MichaelDarr/liclock/README.md

# liclock
the libre chess clock

This document is a work in progress!
