MichaelDarr/liclock/enclosure/liclock.stl

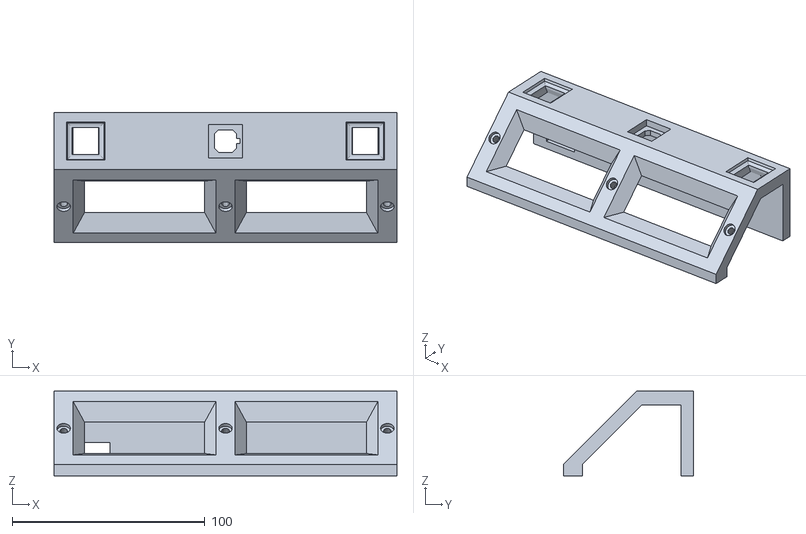
[picture p1: CAD file, 2024-03-15]
enclosure/liclock.stl
178.0 x 67.6 x 44.0
