MichaelDarr/liclock/enclosure/mcs_18_front/mcs_18_front.stl

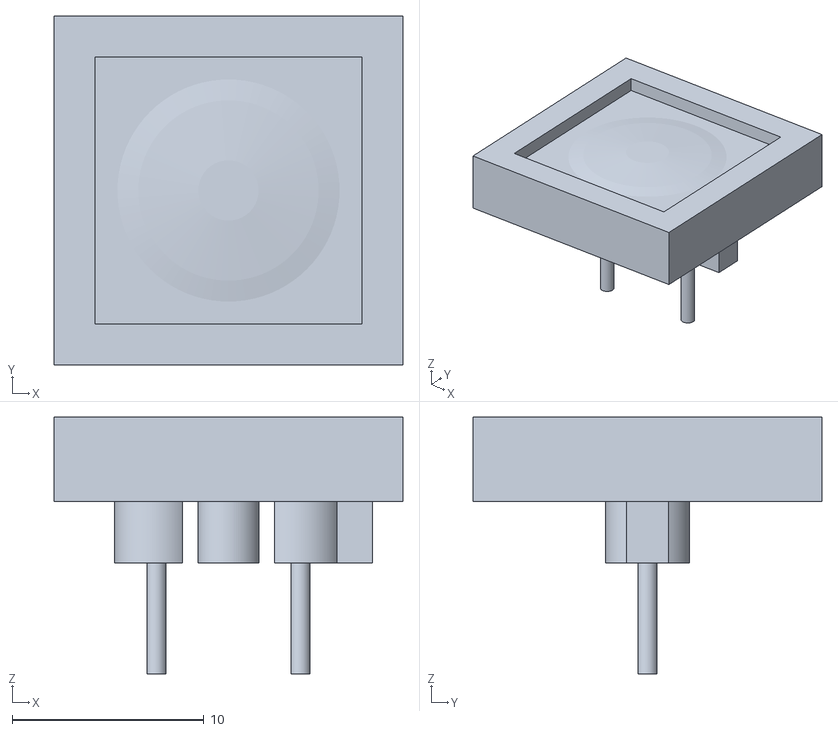
[picture p2: CAD file, 2024-02-21]
enclosure/mcs_18_front/mcs_18_front.stl
18.2 x 18.2 x 13.4
