MichaelDarr/liclock/enclosure/fsr_1.stl

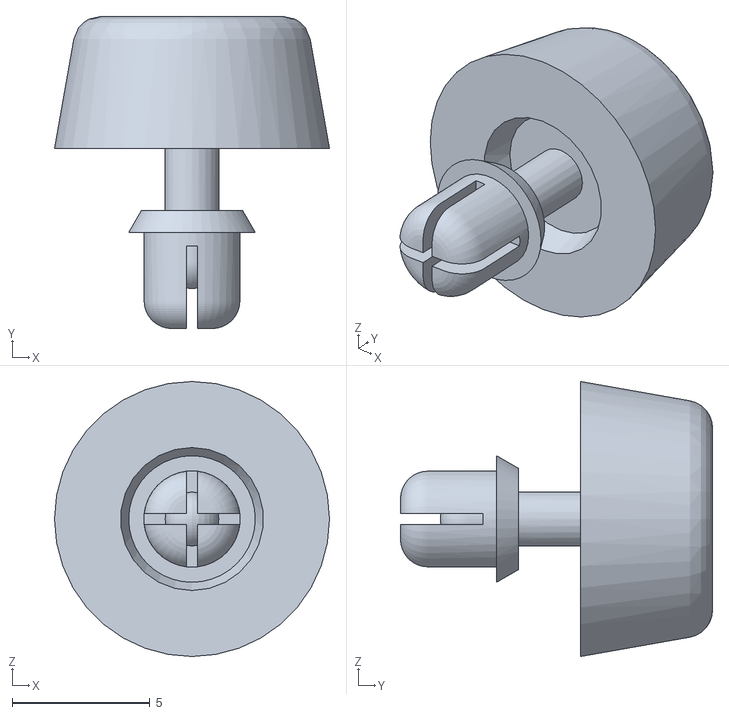
[picture p3: CAD file, 2024-03-13]
enclosure/fsr_1.stl
10.0 x 11.4 x 10.0
