MichaelDarr/liclock/enclosure/switch_mx.stl

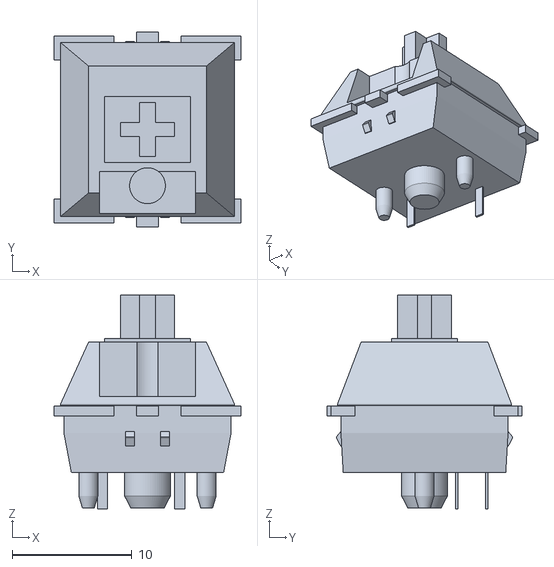
[picture p4: CAD file, 2024-02-21]
enclosure/switch_mx.stl
15.6 x 16.3 x 17.9
