MichaelDarr/liclock/pcb/pcb.kicad_pcb

## KiCad design pcb/pcb.kicad_pcb (2024-03-15)

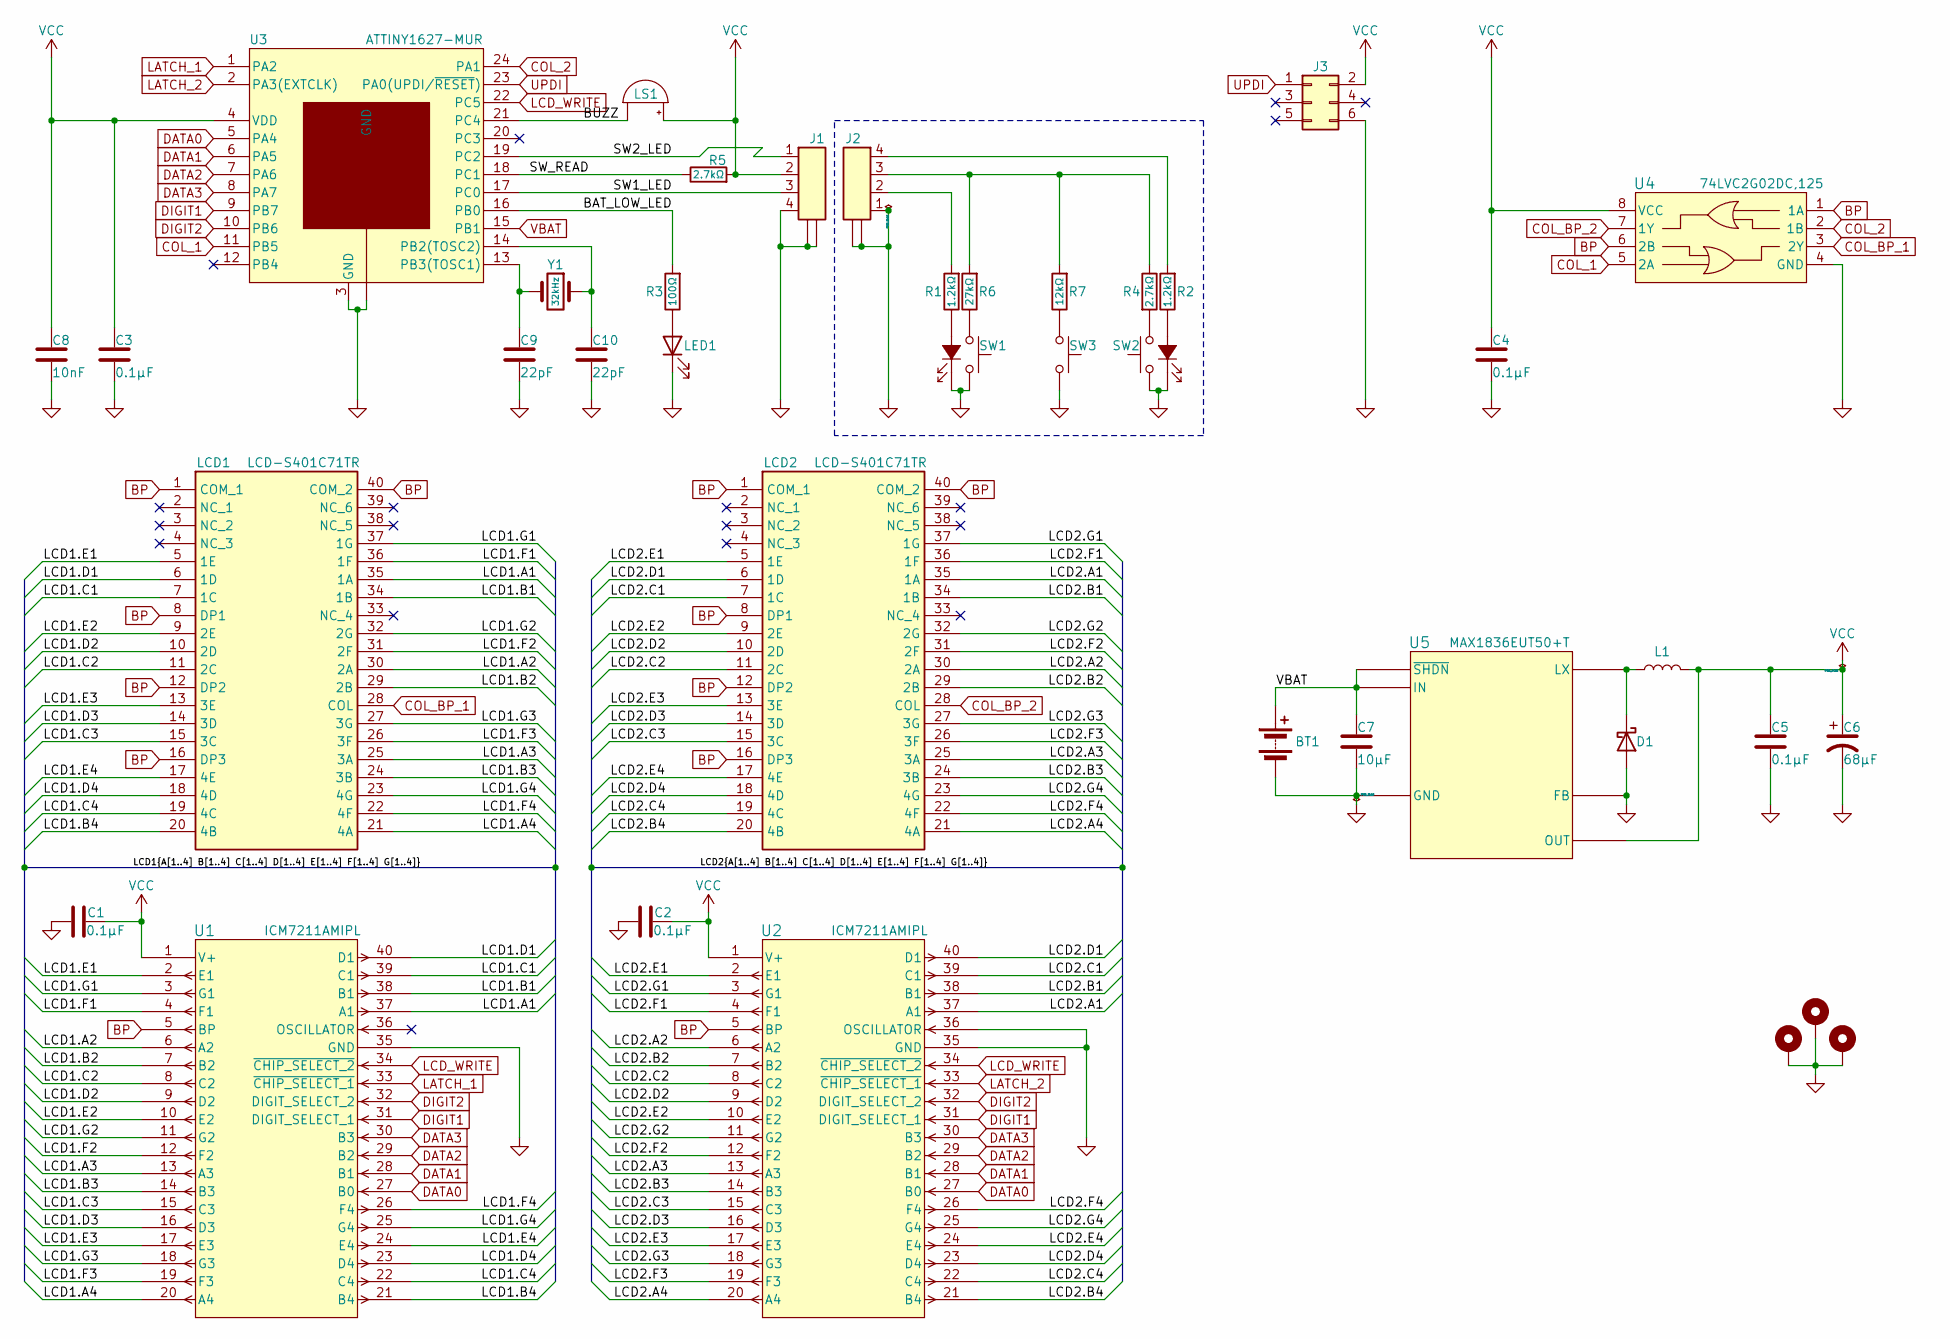
[picture p5: schematic pcb.kicad_sch, Liclock]

Parts:
BT1: ~9V; BATTERY
C1, C2, C3, C4, C5: 0.1µF; C_0805_2012Metric_Pad1.18x1.45mm_HandSolder
C6: 68µF; TPSD686K010R0100
C7: 10µF; C_0805_2012Metric_Pad1.18x1.45mm_HandSolder
C8: 10nF; C_0805_2012Metric_Pad1.18x1.45mm_HandSolder
C9, C10: 22pF; C_0805_2012Metric_Pad1.18x1.45mm_HandSolder
D1: Schottky Diode; B240AE-13
H1, H2, H3: MountingHole_Pad; MountingHole_3.5mm_Pad_TopBottom
J1, J2: Conn_01x04; 2005290040; Mouser Part Number 538-200529-0040
J3: UPDI; PinHeader_2x03_P2.54mm_Vertical
L1: 47μH; Inductor_6060
LCD1, LCD2: LCD-S401C71TR
LED1: Red low battery Indicator; 150060RS75000
LS1: Buzzer; CT-1205H-SMT
R1, R2: 1.2kΩ; R_0805_2012Metric_Pad1.20x1.40mm_HandSolder
R3: 100Ω; R_0805_2012Metric_Pad1.20x1.40mm_HandSolder
R4, R5: 2.7kΩ; R_0805_2012Metric_Pad1.20x1.40mm_HandSolder
R6: 27kΩ; R_0805_2012Metric_Pad1.20x1.40mm_HandSolder
R7: 12kΩ; R_0805_2012Metric_Pad1.20x1.40mm_HandSolder
SW1, SW2: MX Grey w/ LED; MX_LED
SW3: 1241.1100.7095; MCS 18 Front
U1, U2: Display Driver; ICM7211AMIPL
U3: MCU; ATTINY1627
U4: NOR, 2 Channels; TC7WZ32FK_LJCT
U5: Voltage Regulator; MAX1836EUT50+T
Y1: 32kHz; CM315D32768HZFT

Connections:
/BAT_LOW_LED: R3.2, U3.16 (PB0)
/BUZZ: LS1.2 (+), U3.21 (PC4)
/LCD1.A1: LCD1.35 (1A), U1.37 (A1)
/LCD1.A2: LCD1.30 (2A), U1.6 (A2)
/LCD1.A3: LCD1.25 (3A), U1.13 (A3)
/LCD1.A4: LCD1.21 (4A), U1.20 (A4)
/LCD1.B1: LCD1.34 (1B), U1.38 (B1)
/LCD1.B2: LCD1.29 (2B), U1.7 (B2)
/LCD1.B3: LCD1.24 (3B), U1.14 (B3)
/LCD1.B4: LCD1.20 (4B), U1.21 (B4)
/LCD1.C1: LCD1.7 (1C), U1.39 (C1)
/LCD1.C2: LCD1.11 (2C), U1.8 (C2)
/LCD1.C3: LCD1.15 (3C), U1.15 (C3)
/LCD1.C4: LCD1.19 (4C), U1.22 (C4)
/LCD1.D1: LCD1.6 (1D), U1.40 (D1)
/LCD1.D2: LCD1.10 (2D), U1.9 (D2)
/LCD1.D3: LCD1.14 (3D), U1.16 (D3)
/LCD1.D4: LCD1.18 (4D), U1.23 (D4)
/LCD1.E1: LCD1.5 (1E), U1.2 (E1)
/LCD1.E2: LCD1.9 (2E), U1.10 (E2)
/LCD1.E3: LCD1.13 (3E), U1.17 (E3)
/LCD1.E4: LCD1.17 (4E), U1.24 (E4)
/LCD1.F1: LCD1.36 (1F), U1.4 (F1)
/LCD1.F2: LCD1.31 (2F), U1.12 (F2)
/LCD1.F3: LCD1.26 (3F), U1.19 (F3)
/LCD1.F4: LCD1.22 (4F), U1.26 (F4)
/LCD1.G1: LCD1.37 (1G), U1.3 (G1)
/LCD1.G2: LCD1.32 (2G), U1.11 (G2)
/LCD1.G3: LCD1.27 (3G), U1.18 (G3)
/LCD1.G4: LCD1.23 (4G), U1.25 (G4)
/LCD2.A1: LCD2.35 (1A), U2.37 (A1)
/LCD2.A2: LCD2.30 (2A), U2.6 (A2)
/LCD2.A3: LCD2.25 (3A), U2.13 (A3)
/LCD2.A4: LCD2.21 (4A), U2.20 (A4)
/LCD2.B1: LCD2.34 (1B), U2.38 (B1)
/LCD2.B2: LCD2.29 (2B), U2.7 (B2)
/LCD2.B3: LCD2.24 (3B), U2.14 (B3)
/LCD2.B4: LCD2.20 (4B), U2.21 (B4)
/LCD2.C1: LCD2.7 (1C), U2.39 (C1)
/LCD2.C2: LCD2.11 (2C), U2.8 (C2)
/LCD2.C3: LCD2.15 (3C), U2.15 (C3)
/LCD2.C4: LCD2.19 (4C), U2.22 (C4)
/LCD2.D1: LCD2.6 (1D), U2.40 (D1)
/LCD2.D2: LCD2.10 (2D), U2.9 (D2)
/LCD2.D3: LCD2.14 (3D), U2.16 (D3)
/LCD2.D4: LCD2.18 (4D), U2.23 (D4)
/LCD2.E1: LCD2.5 (1E), U2.2 (E1)
/LCD2.E2: LCD2.9 (2E), U2.10 (E2)
/LCD2.E3: LCD2.13 (3E), U2.17 (E3)
/LCD2.E4: LCD2.17 (4E), U2.24 (E4)
/LCD2.F1: LCD2.36 (1F), U2.4 (F1)
/LCD2.F2: LCD2.31 (2F), U2.12 (F2)
/LCD2.F3: LCD2.26 (3F), U2.19 (F3)
/LCD2.F4: LCD2.22 (4F), U2.26 (F4)
/LCD2.G1: LCD2.37 (1G), U2.3 (G1)
/LCD2.G2: LCD2.32 (2G), U2.11 (G2)
/LCD2.G3: LCD2.27 (3G), U2.18 (G3)
/LCD2.G4: LCD2.23 (4G), U2.25 (G4)
/SW1_LED: J1.3, U3.17 (PC0)
/SW2_LED: J1.1, U3.19 (PC2)
/SW_READ: R5.1, U3.18 (PC1)
BP: LCD1.1 (COM_1), LCD1.8 (DP1), LCD1.12 (DP2), LCD1.16 (DP3), LCD1.40 (COM_2), LCD2.1 (COM_1), LCD2.8 (DP1), LCD2.12 (DP2), LCD2.16 (DP3), LCD2.40 (COM_2), U1.5 (BP), U2.5 (BP), U4.1 (1A), U4.6 (2B)
COL_1: U3.11 (PB5), U4.5 (2A)
COL_2: U3.24 (PA1), U4.2 (1B)
COL_BP_1: LCD1.28 (COL), U4.3 (2Y)
COL_BP_2: LCD2.28 (COL), U4.7 (1Y)
DATA0: U1.27 (B0), U2.27 (B0), U3.5 (PA4)
DATA1: U1.28 (B1), U2.28 (B1), U3.6 (PA5)
DATA2: U1.29 (B2), U2.29 (B2), U3.7 (PA6)
DATA3: U1.30 (B3), U2.30 (B3), U3.8 (PA7)
DIGIT1: U1.31 (DIGIT_SELECT_1), U2.31 (DIGIT_SELECT_1), U3.9 (PB7)
DIGIT2: U1.32 (DIGIT_SELECT_2), U2.32 (DIGIT_SELECT_2), U3.10 (PB6)
GND: BT1.2 (-), C1.1, C2.1, C3.1, C4.2, C5.2, C6.2, C7.2, C8.2, C9.1, C10.1, D1.2 (A), H1.1, H2.1, H3.1, J1.4, J1.5, J1.6, J3.6, LED1.1 (K), U1.35 (GND), U2.35 (GND), U2.36 (OSCILLATOR), U3.3 (GND), U3.25 (GND), U4.4 (GND), U5.1 (FB), U5.2 (GND)
GND1: J2.1, J2.5, J2.6, SW1.1, SW1.3 (K), SW2.1, SW2.3 (K), SW3.2
LATCH_1: U1.33 (~CHIP_SELECT_1), U3.1 (PA2)
LATCH_2: U2.33 (~CHIP_SELECT_1), U3.2 (PA3(EXTCLK))
LCD_WRITE: U1.34 (~CHIP_SELECT_2), U2.34 (~CHIP_SELECT_2), U3.22 (PC5)
unnamed: D1.1 (K), L1.2, U5.4 (LX)
unnamed: J2.2, R1.2
unnamed: J2.3, R4.1, R6.2, R7.2
unnamed: J2.4, R2.2
unnamed: LED1.2 (A), R3.1
unnamed: R4.2, SW2.2
unnamed: R6.1, SW1.2
unnamed: R7.1, SW3.1
unnamed: R1.1, SW1.4 (A)
unnamed: R2.1, SW2.4 (A)
unnamed: C10.2, U3.14 (PB2(TOSC2)), Y1.1
unnamed: C9.2, U3.13 (PB3(TOSC1)), Y1.2
UPDI: J3.1, U3.23 (PA0(UPDI/~RESET))
VBAT: BT1.1 (+), C7.1, U3.15 (PB1), U5.3 (IN), U5.5 (~SHDN)
VCC: C1.2, C2.2, C3.2, C4.1, C5.1, C6.1, C8.1, J1.2, J3.2, L1.1, LS1.1 (-), R5.2, U1.1 (V+), U2.1 (V+), U3.4 (VDD), U4.8 (VCC), U5.6 (OUT)

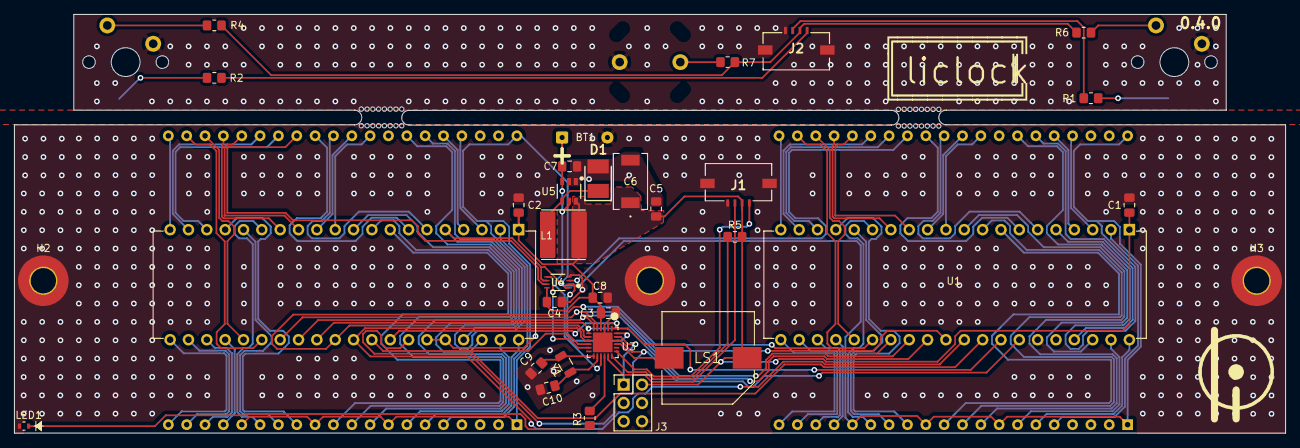
[picture p6: board pcb.kicad_pcb from above]

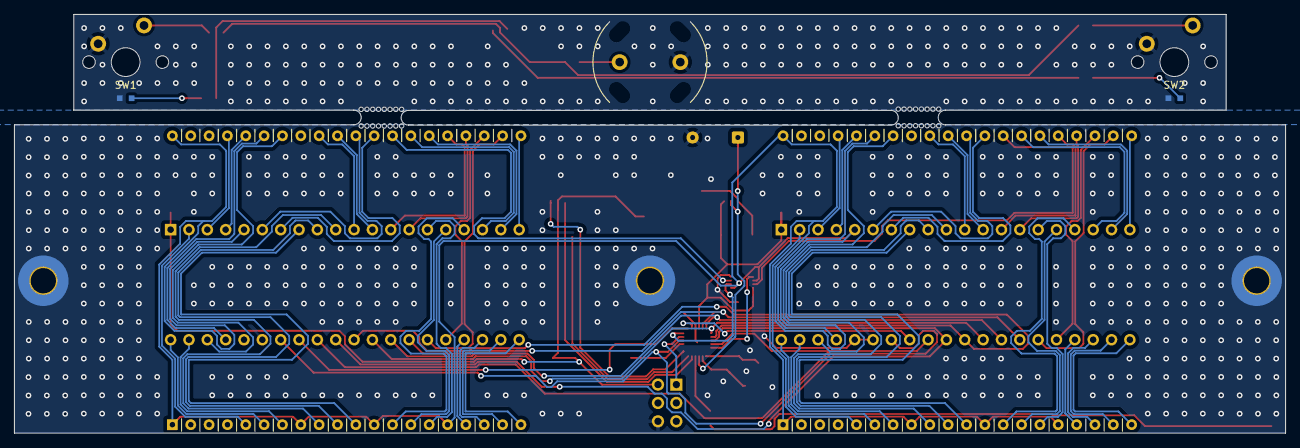
[picture p7: board pcb.kicad_pcb from below]

Board: 2 copper layers, 176.0 x 58.0 mm, 39 parts (5 on the bottom side), 92 nets.
