MichaelDarr/liclock/(commit log)

2023-11-22 Add schematic draft
    [pcb.kicad_pcb, pcb.kicad_sch]
2023-11-27 Implement timer swaps on new clock
    [chess_clock.rs, descriptor.rs, main.rs, timer.rs]
2023-12-01 Migrate to attiny84a
    [pcb.kicad_sch]
2023-12-09 Update schematic
    [pcb.kicad_sch]
2023-12-12 Improve signal integrity
    [pcb.kicad_sch]
2023-12-15 Simplify switch reading loop
2023-12-15 initialize pcb design
    [pcb.kicad_pcb, pcb.kicad_sch]
2023-12-22 begin split pcb layout
    [pcb.kicad_pcb, pcb.kicad_sch]
2023-12-22 Separate board halves
    [pcb.kicad_pcb]
2023-12-27 Finish basic pcb layout
    [pcb.kicad_pcb, pcb.kicad_sch]
2023-12-28 solve solder mask errors
    [pcb.kicad_pcb, pcb.kicad_sch]
2023-12-29 Prepare for connection
    [pcb.kicad_pcb, pcb.kicad_sch]
2023-12-29 crush every error
    [pcb.kicad_pcb, pcb.kicad_sch]
2023-12-30 Add some snazy art
    [pcb.kicad_pcb]
2023-12-30 Add mouse bites
    [pcb.kicad_pcb]
2023-12-30 Add some models
    [pcb.kicad_pcb]
2024-01-02 Add picture of 0.1.0 schematic
2024-01-02 narrow down schematic for v0.2.0
    [pcb.kicad_sch]
2024-01-02 Fix violations
    [pcb.kicad_sch]
2024-01-04 standardize cross-connector net names
    [pcb.kicad_pcb, pcb.kicad_sch]
2024-01-05 Update mcs 18 front footprint
    [pcb.kicad_pcb]
2024-01-07 remove the self
    [pcb.kicad_pcb]
2024-01-07 Remove outdated schematic
2024-01-23 Set up firmware for new board
2024-02-05 Move micro onto LCD board
    [pcb.kicad_pcb, pcb.kicad_sch]
2024-02-21 Initialize enclosure
    [CWSA11AAN1H.stl, LCD-S401C71TR.stl, liclock.scad, mcs_18_front.scad, mcs_18_front.step, mcs_18_front.stl, switch_mx.stl]
2024-02-21 back up pcb work
    [pcb.kicad_pcb, pcb.kicad_sch]
2024-02-21 Redo pcb layout
    [pcb.kicad_pcb, pcb.kicad_sch, pcb_v1.kicad_pcb]
2024-02-22 Finalize initial design
    [liclock.scad, pcb.kicad_pcb, pcb.kicad_sch, pcb_v1.kicad_pcb]
2024-02-22 Make clock smaller
    [liclock.scad]
2024-02-23 Fix mounting hole margin
    [pcb.kicad_pcb]
2024-02-23 Add extensive mounting holes
    [pcb.kicad_pcb, pcb.kicad_sch]
2024-02-23 compile enclosure
    [liclock.scad, liclock.stl]
2024-02-23 Fix paths
    [pcb.kicad_pcb]
2024-02-23 make fine adjustments
    [liclock.scad, liclock.stl]
2024-02-29 Slight pcb improvements
    [pcb.kicad_pcb]
2024-02-29 Fix many issues
    [pcb.kicad_pcb, pcb.kicad_sch]
2024-03-03 Fix pcb issues
    [pcb.kicad_pcb, pcb.kicad_sch]
2024-03-13 Fine adjustments
    [pcb.kicad_pcb, pcb.kicad_sch]
2024-03-13 Add footer holes
    [fsr_1.stl, liclock.scad, liclock.stl]
2024-03-15 Increase switch pin spacing
    [pcb.kicad_pcb]
2024-03-15 Increase footer bezel
    [liclock.scad, liclock.stl]
